JuanGonzalez47/CubeSat_UD34_Electronic_Products_Design/README.md

# CubeSat_UD34_Electronic_Products_Design
Electronic design and architecture of the 1U CubeSat (UD34) nanosatellite for multispectral agricultural monitoring. Electronic Product Design Laboratory - Universidad de Antioquia.
