JuanGonzalez47/CubeSat_UD34_Electronic_Products_Design/Lab04/Informe_tecnico/tablas/costos_detalle.tex

\scriptsize
\setlength{\tabcolsep}{3pt}
\renewcommand{\arraystretch}{1.15}
\begin{longtable}{|>{\raggedright\arraybackslash}p{0.5cm}|>{\raggedright\arraybackslash}p{2.3cm}|>{\raggedright\arraybackslash}p{1.0cm}|>{\raggedright\arraybackslash}p{1.2cm}|>{\raggedright\arraybackslash}p{1.2cm}|>{\raggedright\arraybackslash}p{1.3cm}|>{\raggedright\arraybackslash}p{1.3cm}|>{\raggedright\arraybackslash}p{1.4cm}|>{\raggedright\arraybackslash}p{1.5cm}|>{\raggedright\arraybackslash}p{2.2cm}|}
\hline
\textbf{\#} & \textbf{Designadores} & \textbf{Pzs/tarjeta} & \textbf{USD u. (10)} & \textbf{USD u. (100)} & \textbf{USD u. (1000)} & \textbf{Costo (10)} & \textbf{Costo (100)} & \textbf{Costo (1000)} & \textbf{Estado del precio} \\ \hline
\endfirsthead
\hline
\textbf{\#} & \textbf{Designadores} & \textbf{Pzs/tarjeta} & \textbf{USD u. (10)} & \textbf{USD u. (100)} & \textbf{USD u. (1000)} & \textbf{Costo (10)} & \textbf{Costo (100)} & \textbf{Costo (1000)} & \textbf{Estado del precio} \\ \hline
\endhead
1 & U1 & 1 & 8.0151 & 6.5870 & 6.5870 & 80.15 & 658.70 & 6587.00 & Cotizado \\ \hline
2 & *1 & 1 & 4.6209 & 4.2064 & 3.5938 & 46.21 & 420.64 & 3593.80 & Cotizado (sin stock) \\ \hline
3 & U2 & 1 & 4.8816 & 4.8816 & 4.8816 & 48.82 & 488.16 & 4881.60 & ESTIMADO \\ \hline
4 & U3 & 1 & 0.8819 & 0.6642 & 0.5901 & 8.82 & 66.42 & 590.10 & Cotizado \\ \hline
5 & U4 & 1 & 0.5379 & 0.4006 & 0.3511 & 5.38 & 40.06 & 351.10 & Cotizado \\ \hline
6 & Y1 & 1 & 0.5644 & 0.4321 & 0.4321 & 5.64 & 43.21 & 432.10 & ESTIMADO (variante) \\ \hline
7 & C1, C6 & 2 & 0.0240 & 0.0132 & 0.0080 & 0.48 & 2.64 & 16.00 & Cotizado \\ \hline
8 & R1 & 1 & 0.0340 & 0.0256 & 0.0256 & 0.34 & 2.56 & 25.60 & Cotizado \\ \hline
9 & R6, R7 & 2 & 0.0340 & 0.0256 & 0.0256 & 0.68 & 5.12 & 51.20 & ESTIMADO (proxy) \\ \hline
10 & R2, R3, R4, R5 & 4 & 0.0256 & 0.0256 & 0.0256 & 1.02 & 10.24 & 102.40 & ESTIMADO (proxy) \\ \hline
11 & C2, C5 & 2 & 0.0500 & 0.0200 & 0.0120 & 1.00 & 4.00 & 24.00 & ESTIMADO \\ \hline
12 & C3, C4 & 2 & 0.1000 & 0.0500 & 0.0300 & 2.00 & 10.00 & 60.00 & ESTIMADO \\ \hline
13 & C7 & 1 & 0.1500 & 0.0800 & 0.0500 & 1.50 & 8.00 & 50.00 & ESTIMADO \\ \hline
14 & J1 & 1 & 0.7446 & 0.7423 & 0.6976 & 7.45 & 74.23 & 697.62 & Cotizado (RS, SGD) \\ \hline
15 & J2 (J\_EPS) & 3 & 0.0800 & 0.0500 & 0.0300 & 2.40 & 15.00 & 90.00 & ESTIMADO \\ \hline
16 & J3 (J\_COIL\_X) & 2 & 0.0800 & 0.0500 & 0.0300 & 1.60 & 10.00 & 60.00 & ESTIMADO \\ \hline
17 & J4 (J\_COIL\_Y) & 2 & 0.0800 & 0.0500 & 0.0300 & 1.60 & 10.00 & 60.00 & ESTIMADO \\ \hline
18 & P1 (J\_PAYLOAD) & 5 & 0.0800 & 0.0500 & 0.0300 & 4.00 & 25.00 & 150.00 & ESTIMADO \\ \hline
19 & P2 (J\_CAMERA) & 16 & 0.0500 & 0.0300 & 0.0300 & 8.00 & 48.00 & 480.00 & ESTIMADO \\ \hline
20 & P3 (J\_TELEM) & 4 & 0.0800 & 0.0500 & 0.0300 & 3.20 & 20.00 & 120.00 & ESTIMADO \\ \hline
\end{longtable}
\normalsize
