JuanGonzalez47/CubeSat_UD34_Electronic_Products_Design/Lab04/Informe_tecnico/tablas/costos_resumen.tex

\small
\setlength{\tabcolsep}{3pt}
\renewcommand{\arraystretch}{1.15}
\begin{longtable}{|>{\raggedright\arraybackslash}p{2.8cm}|>{\raggedright\arraybackslash}p{3.6cm}|>{\raggedright\arraybackslash}p{3.6cm}|>{\raggedright\arraybackslash}p{6cm}|}
\hline
\textbf{Tamaño del lote} & \textbf{Costo de componentes del lote (USD)} & \textbf{Costo de componentes por tarjeta (USD)} & \textbf{Observaciones} \\ \hline
\endfirsthead
\hline
\textbf{Tamaño del lote} & \textbf{Costo de componentes del lote (USD)} & \textbf{Costo de componentes por tarjeta (USD)} & \textbf{Observaciones} \\ \hline
\endhead
10 tarjetas & 230.29 & 23.03 & Escalón de 10 piezas en los ICs; poco descuento. \\ \hline
100 tarjetas & 1,961.98 & 19.62 & Se alcanzan escalones de 100+ piezas en los ICs principales. \\ \hline
1000 tarjetas & 18,422.52 & 18.42 & Se aplica el último escalón publicado cuando la cantidad lo supera (conservador). \\ \hline
\end{longtable}
\normalsize
