JuanGonzalez47/CubeSat_UD34_Electronic_Products_Design/Lab04/Informe_tecnico/tablas/restricciones.tex

\tiny
\setlength{\tabcolsep}{3pt}
\renewcommand{\arraystretch}{1.15}
\begin{longtable}{|>{\raggedright\arraybackslash}p{1.1cm}|>{\raggedright\arraybackslash}p{1.8cm}|>{\raggedright\arraybackslash}p{5.6cm}|>{\raggedright\arraybackslash}p{1.6cm}|>{\raggedright\arraybackslash}p{4.0cm}|>{\raggedright\arraybackslash}p{1.8cm}|}
\hline
\textbf{ID} & \textbf{Origen} & \textbf{Restricción y alcance} & \textbf{Tipo} & \textbf{Fuente y fundamento} & \textbf{Estado} \\ \hline
\endfirsthead
\hline
\textbf{ID} & \textbf{Origen} & \textbf{Restricción y alcance} & \textbf{Tipo} & \textbf{Fuente y fundamento} & \textbf{Estado} \\ \hline
\endhead
PCB-01 & ET alimentación / MAIN\_BUS\_POWER & Pista de MAIN\_BUS\_POWER (J\_EPS pin 1) y VM del DRV8833: ancho mínimo según Calculos B28 ($\approx$0,30 mm para 1 A y $\approx$0,53 mm para 1,5 A, $\Delta$T 10 \textdegree{}C, 1 oz externa); usar $\geq$ 1 mm como objetivo de diseño por margen y caída de tensión. Evitar cuellos de botella en vías: mínimo 2 vías 0,3/0,6 mm por transición. & Inferencia + recomendación & IPC-2221 (cálculo en hoja Calculos); corriente supuesta 1 A (informe previo 1-1,5 A). & Pendiente de layout \\ \hline
PCB-02 & Dominio ADCS aislado & Dominios DGND y PGND separados galvánicamente. Distancia mínima (creepage/clearance) entre copper de DGND y de PGND en la zona del ISO7741: $\geq$ 8 mm de pad a pad en el aislador DW (SOIC-16 ancho) y sin cobre ni planos bajo el aislador en la barrera. & Exigida por componente + recomendación & ISO7741DWR: aislamiento 5000 Vrms (DigiKey/TI). Distancia exacta: hoja de datos TI, sección Package/Insulation Specifications (por confirmar valor numérico). & Pendiente de layout \\ \hline
PCB-03 & Dominio ADCS aislado & El plano/retorno de PGND no debe cruzar ni solaparse con DGND. Un único punto de conexión no existe (aislamiento total); los retornos de las bobinas vuelven a PGND por el lado del DRV8833. & Recomendación & Práctica estándar de aislamiento galvánico; cambio documentado en el informe, Sección 2.3. & Pendiente de layout \\ \hline
PCB-04 & DRV8833 / J\_COIL\_X, J\_COIL\_Y & Pad térmico (PowerPAD) de U4 conectado a PGND con matriz de vías térmicas (mín. 5 vías 0,3 mm de taladro) a plano de PGND. Zona de cobre ampliada alrededor del pad. & Recomendación del fabricante & Hoja de datos DRV8833, sección Layout (PowerPAD) - confirmar número de vías recomendado. & Pendiente de layout \\ \hline
PCB-05 & STM32H753 / alimentación & Un condensador de desacoplamiento de 100 nF por cada par VDD/VSS, a $\leq$ 3 mm del pin, con vía directa al plano. El esquemático actual NO incluye estos condensadores (ver Desviaciones D-08); deben añadirse o compensarse con condensadores en la zona de layout. & Exigida por hoja de datos & AN4938 / datasheet STM32H753 (sección Power supply scheme). Cantidad exacta por confirmar. & Desviación abierta \\ \hline
PCB-06 & STM32H753 / VCAP & Condensadores VCAP (C3, C4 de 2,2 uF) lo más cerca posible de los pines VCAP (81, 125), ESR < 100 mohm (cerámico X7R/X5R). & Exigida por hoja de datos & Datasheet STM32H753, sección Power supply scheme (VCAP). Confirmar valor y ESR. & Pendiente de layout \\ \hline
PCB-07 & Reloj HSE & Cristal Y1 y condensadores C2, C5 juntos, a $\leq$ 5 mm de PH0/PH1; sin pistas de otras señales ni vías bajo el cristal; guarda de GND (DGND) alrededor. & Recomendación del fabricante & AN2867 (Oscillator design guide for STM8/STM32) - confirmar aplicabilidad al H7. & Pendiente de layout \\ \hline
PCB-08 & Reloj HSE & Capacitancia de carga CL = 18 pF (a verificar): requiere Cext $\approx$ 30 pF por lado con Cstray = 3 pF; instalado 16 pF. Desviación abierta. & Exigida por hoja de datos & Hoja de datos ABM3B-25.000MHZ-B4U-T (por confirmar) + Calculos B3-B9. & Desviación abierta \\ \hline
PCB-09 & IF-04 PAYLOAD\_SPI & SPI hacia el payload: resistencias serie de 33 ohm (R2-R5) ubicadas cerca del origen (STM32). Longitud de pista < 100 mm si es posible; sin cruces de planos. & Recomendación & Práctica de integridad de señal; impedancia no controlada en esta etapa. & Pendiente de layout \\ \hline
PCB-10 & IF-05 TELEMETRY\_I2C & Pull-ups de 4,7 kohm (R6, R7) a 3V3\_DIGITAL dentro del intervalo [967 ohm; 7,08 kohm]. & Cálculo & Hoja Calculos B16-B19 (especificación I2C). & Cumple \\ \hline
PCB-11 & IF-01 CAMERA\_DCMI & Bus DCMI (D0-D7, PCLK, HSYNC, VSYNC): grupo de longitud con diferencia máxima entre D0-D7 y PCLK a definir en la guía de enrutamiento (objetivo preliminar $\leq$ 5 mm); referencia continua de plano. & Inferencia (objetivo) & Requisito ET-01 $\geq$ 40 MB/s (informe). Valor numérico por derivar de la hoja de datos de la cámara (no disponible en este paquete). & Pendiente (valor por definir) \\ \hline
PCB-12 & FMC\_BUS (SDRAM) & Bus FMC SDRAM: línea de reloj FMC\_SDCLK emparejada en longitud con el grupo de datos/control (objetivo $\leq$ 10 mm de diferencia); cobertura por plano de referencia; la SDRAM junto al STM32. & Inferencia (objetivo) & Práctica común para SDRAM síncrona (timing del MT48LC4M16A2P-6A, hoja de datos: sección AC Timing). Valores numéricos por confirmar. & Pendiente (valor por definir) \\ \hline
PCB-13 & SDIO\_BUS (eMMC) & Bus SDIO: CLK separado de D0-D7 y CMD; diferencia de longitud entre líneas $\leq$ 5 mm (objetivo); eMMC en BGA FBGA-153: abanico con vías de 0,15-0,2 mm (HDI o POFV según proveedor). & Inferencia + límite de fabricación & Datasheet Kingston EMMC04G-M627-A01 (por confirmar) y guía BGA de JLCPCB (\url{https://jlcpcb.com/help/article/243-BGA-Design-Guidelines---PCB-Layout-Recommendations-for-BGA-packages}). & Pendiente de layout \\ \hline
PCB-14 & SWD (J1) & SWDIO y SWCLK cortos (< 50 mm) hacia el conector J1; NRST disponible en test point. & Recomendación & Práctica; el informe prevé puntos de prueba NRST, VCAP, 3.3V\_Iso y PWM. & Desviación abierta \\ \hline
PCB-15 & Térmico & Disipación del DRV8833 y de las pistas de bobinas: cobre de superficie ampliado y, si se justifica, capa interna de potencia; $\Delta$T admisible 10 \textdegree{}C como objetivo. & Recomendación & Hoja de datos DRV8833; IPC-2221. & Pendiente \\ \hline
PCB-16 & Conectores & J1 (53259-0429) y cabeceras de cables en el borde de la tarjeta; huella de THT con agujeros de taladro según datasheet Molex; pitch 3,5 mm (J1). & Exigida por huella & Datasheet Molex 53259-0429 (patrón recomendado). & Pendiente de verificación \\ \hline
FAB-01 & Proveedor & Proveedor elegido: JLCPCB (fabricación de PCB rígida estándar). Capacidades consultadas el 27/10/2026 en \url{https://jlcpcb.com/capabilities/pcb-capabilities} y \url{https://api.jlcpcb.com/capabilities/Capabilities.} Los valores pueden cambiar; reconsultar antes del pedido. & Fuente externa & JLCPCB, páginas de capacidades (fecha de consulta 27/10/2026). & Documentado \\ \hline
FAB-02 & Apilamiento & Número de capas preliminar: 4 capas (señal / GND / alimentación / señal), FR-4, 1,6 mm, cobre exterior 1 oz (0,035 mm). Justificación: BGA FBGA-153, 176 pines LQFP, bus FMC de 38 señales y dominios aislados. Cálculo de impedancias y apilamiento definitivos quedan para la guía de enrutamiento. & Inferencia & JLCPCB: soporta 1-32 capas, impedancia controlada de 4 capas en adelante, con apilamientos por defecto. & Pendiente (valor preliminar) \\ \hline
FAB-03 & Pistas y separación & Ancho y separación mínimos en capa exterior a usar en diseño: $\geq$ 0,127 mm (5 mil) / 0,127 mm (5 mil) para 1-2 capas; objetivo de diseño $\geq$ 0,15 mm / 0,15 mm para tener margen. En multicapa JLCPCB indica 3,5 mil como límite; no se usa por margen. & Límite de fabricante & JLCPCB capabilities (resumen verificado vía secundaria: Trace width/spacing 5 mil 1-2L; 3,5 mil multicapa). Reconsultar el valor exacto de 4 capas en la página oficial. & Pendiente de layout \\ \hline
FAB-04 & Vías y taladros & Vía estándar: taladro 0,3 mm / diámetro 0,5 mm (2 capas) o taladro 0,2 mm / diámetro 0,45 mm (multicapa); vías de abanico de BGA con taladro 0,15 mm / diámetro 0,25 mm (según la guía BGA y 'Via-in-pad' con relleno, POFV gratuito en 6-20 capas). Taladro mínimo 0,2 mm; máximo 6,3 mm. & Límite de fabricante & JLCPCB capabilities (\url{https://api.jlcpcb.com/capabilities/Capabilities}) y guía BGA (\url{https://jlcpcb.com/help/article/243-BGA-Design-Guidelines---PCB-Layout-Recommendations-for-BGA-packages}). & Pendiente de layout \\ \hline
FAB-05 & Anillo anular / máscara & Anillo anular mínimo de pad $\geq$ 0,15 mm sobre el taladro (valor registrado por fuente secundaria). Puente de máscara de soldadura mínimo según proveedor; verificar para el paso de 0,5 mm del LQFP-176 y del FBGA-153. & Límite de fabricante & JLCPCB (valores a confirmar en la página oficial); la separación mínima entre pines de IC es 0,4 mm (0,35 mm extremo). & Pendiente (confirmar) \\ \hline
FAB-06 & Borde de tarjeta & Distancia de pista a borde $\geq$ 0,2 mm (fresado) como límite del fabricante; objetivo de diseño $\geq$ 0,3 mm. Tamaño de lote en prototipo: tarjeta individual 70x70 mm mínimo / 400x500 mm máximo en el servicio estándar. & Límite de fabricante & JLCPCB capabilities (Trace to Outline 0,2 mm; Single PCB Size). & Pendiente \\ \hline
FAB-07 & Tamaño de la placa & Tamaño de la PCB debe respetar el formato 1U del CubeSat (\textasciitilde{} 90 x 96 mm de la placa PC/104). Si es menor de 70 x 70 mm, verificar los mínimos del servicio estándar de JLCPCB. & Inferencia & Estándar CubeSat 1U / PC/104 (por confirmar en la arquitectura de la práctica 3). & Pendiente \\ \hline
FAB-08 & Servicios especiales & Posible necesidad de servicio especial: vía rellena (POFV/via-in-pad) y/o HDI para el FBGA-153 a paso 0,5 mm; impedancia controlada si se exige. Identificado para consultar a JLCPCB. & Inferencia & Guía BGA de JLCPCB. & Pendiente \\ \hline
\end{longtable}
\normalsize
