JuanGonzalez47/CubeSat_UD34_Electronic_Products_Design/Lab03/Diagrama/Diagrama_con_pcb.png

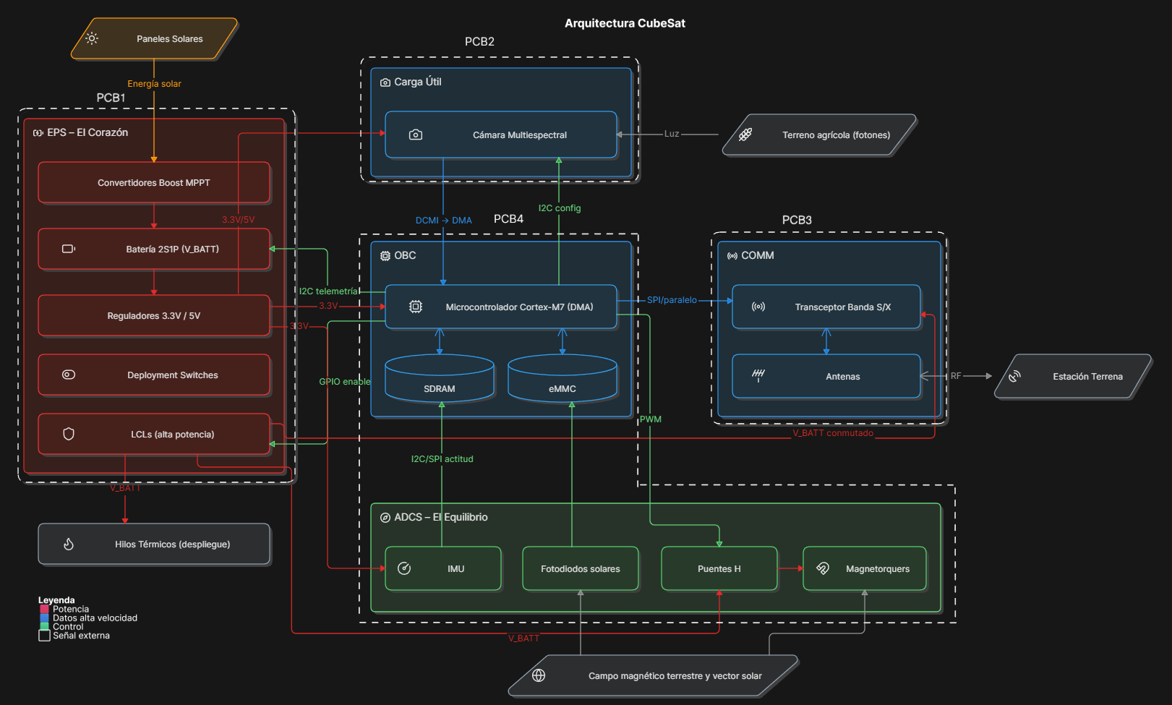
Lab03/Diagrama/Diagrama_con_pcb.png
