JuanGonzalez47/CubeSat_UD34_Electronic_Products_Design/Lab04/Informe_tecnico/tablas/bom.tex

\scriptsize
\setlength{\tabcolsep}{3pt}
\renewcommand{\arraystretch}{1.15}
\begin{longtable}{|>{\raggedright\arraybackslash}p{0.5cm}|>{\raggedright\arraybackslash}p{2.2cm}|>{\raggedright\arraybackslash}p{3.8cm}|>{\raggedright\arraybackslash}p{0.8cm}|>{\raggedright\arraybackslash}p{2.2cm}|>{\raggedright\arraybackslash}p{3.2cm}|>{\raggedright\arraybackslash}p{2.4cm}|}
\hline
\textbf{\#} & \textbf{Designadores} & \textbf{Descripción} & \textbf{Cant.} & \textbf{Fabricante} & \textbf{Referencia (MPN)} & \textbf{Encapsulado} \\ \hline
\endfirsthead
\hline
\textbf{\#} & \textbf{Designadores} & \textbf{Descripción} & \textbf{Cant.} & \textbf{Fabricante} & \textbf{Referencia (MPN)} & \textbf{Encapsulado} \\ \hline
\endhead
1 & U1 & Microcontrolador ARM Cortex-M7 480 MHz, 2 MB Flash & 1 & STMicroelectronics & STM32H753IIT6 & LQFP-176 (24x24) \\ \hline
2 & *1 & eMMC 4 GB & 1 & Kingston & EMMC04G-M627-A01 & FBGA-153 \\ \hline
3 & U2 & SDRAM 64 Mbit (4M x 16), 3,3 V & 1 & Micron & MT48LC4M16A2P-6A & TSOP-II 54 \\ \hline
4 & U3 & Aislador digital 4 canales (3 + 1), 5 kVrms & 1 & Texas Instruments & ISO7741DWR & SOIC-16 DW \\ \hline
5 & U4 & Puente H doble 2,7-10,8 V & 1 & Texas Instruments & DRV8833PWPR & HTSSOP-16 (PowerPAD) \\ \hline
6 & Y1 & Cristal 25 MHz (HSE) & 1 & Abracon & ABM3B-25.000MHZ-B4U-T & SMD 5,0 x 3,2 mm, 4 pines \\ \hline
7 & C1, C6 & Condensador cerámico 0,1 uF X7R 16 V & 2 & Murata & GRM155R71C104KA88D & 0402 \\ \hline
8 & R1 & Resistencia 10 kOhm 1 \% 0603 & 1 & Panasonic & ERJ3EKF1002V & 0603 \\ \hline
9 & R6, R7 & Resistencia 4,7 kOhm 0603 & 2 & Panasonic (a definir) & Serie ERJ3EKF (valor 4,7 kOhm, MPN por confirmar) & 0603 \\ \hline
10 & R2, R3, R4, R5 & Resistencia serie 33 ohm 0603 & 4 & Panasonic (a definir) & Serie ERJ3EKF (valor 33 ohm, MPN por confirmar) & 0603 \\ \hline
11 & C2, C5 & Condensador 16 pF C0G (carga del cristal) & 2 & A definir & Por confirmar & 0402 (a verificar) \\ \hline
12 & C3, C4 & Condensador 2,2 uF (VCAP del STM32) & 2 & A definir & Por confirmar & 0603 (a verificar) \\ \hline
13 & C7 & Condensador 10 uF (filtrado J\_EPS) & 1 & A definir & Por confirmar & 0805 (a verificar) \\ \hline
14 & J1 & Cabecera 4 pines 3,5 mm SWD & 1 & Molex & 53259-0429 & THT acodada 3,5 mm \\ \hline
15 & J2 (J\_EPS) & Cabecera 3 pines (potencia EPS) & 1 & Genérico & Sin referencia comercial & Cabecera 3 pines \\ \hline
16 & J3 (J\_COIL\_X) & Cabecera 2 pines (bobina X) & 1 & Genérico & Sin referencia comercial & Cabecera 2 pines \\ \hline
17 & J4 (J\_COIL\_Y) & Cabecera 2 pines (bobina Y) & 1 & Genérico & Sin referencia comercial & Cabecera 2 pines \\ \hline
18 & P1 (J\_PAYLOAD) & Cabecera 5 pines (SPI + DGND) & 1 & Genérico & Sin referencia comercial & Cabecera 5 pines \\ \hline
19 & P2 (J\_CAMERA) & Cabecera 16 pines (DCMI + I2C + 3V3 + DGND) & 1 & Genérico & Sin referencia comercial & Cabecera 16 pines \\ \hline
20 & P3 (J\_TELEM) & Cabecera 4 pines (I2C + 3V3 + DGND) & 1 & Genérico & Sin referencia comercial & Cabecera 4 pines \\ \hline
\end{longtable}
\normalsize
