JuanGonzalez47/CubeSat_UD34_Electronic_Products_Design/Lab04/Calculos_BOM/UD34_PCB2_Calculos_BOM_Costos.xlsx

Sheet: Leeme
PCB 2 (OBC + ADCS) - CubeSat UD34 - Práctica 4
Hoja de cálculo de soporte: supuestos, BOM, costos, cálculos, matriz de restricciones, registro ERC y desviaciones.
Integrantes: Juan Pablo González Blandón, Santiago Castaño Loaiza. Altium Designer 26.9.1. Fecha de consulta de precios y proveedor: 27/10/2026.
Hojas
Supuestos: tipo de cambio, tamaños de lote, constantes (celdas amarillas = editables).
Precios: escalones de precio por componente (fuente, moneda, fecha). Fondo naranja = precio ESTIMADO sin cotización.
BOM: lista de materiales del esquemático entregado (as-built).
Costos: costo por lote 10/100/1000 con fórmulas, y costo por tarjeta + gráfica.
Calculos: cristal HSE, pull-ups I2C, ancho de pista (IPC-2221), consumo.
Restricciones: matriz de restricciones de PCB y de fabricación (ID, restricción, fuente, verificación, estado).
ERC: registro de la validación automática y manual, con excepciones aceptadas.
Desviaciones: diferencias entre la especificación/informe previo y el esquemático as-built.
Convenciones
Amarillo = dato de entrada editable. Naranja = valor estimado/pendiente de cotización. Verde = encabezado.
Los precios con escalones usan el escalón de cantidad correspondiente a la cantidad de piezas del lote (cantidad por tarjeta x tarjetas), no al número de tarjetas.
Si la cantidad supera el último escalón publicado, se aplica el último precio publicado (conservador). Los escalones no usados se rellenan con cantidades ficticias >= 1.000.000 y el último precio.
No incluye fabricación de la PCB, ensamblaje, transporte ni impuestos.

Sheet: Supuestos
Parámetro | Valor | Unidad | Fuente / nota
Tarjetas en lote 1 | 10 | uds | Guía Práctica 4, paso 11
Tarjetas en lote 2 | 100 | uds | Guía Práctica 4, paso 11
Tarjetas en lote 3 | 1000 | uds | Guía Práctica 4, paso 11
Tipo de cambio SGD -> USD | 0.77 | USD/SGD | SUPUESTO del equipo (aprox.). Actualizar con la tasa del día de compra.
Tipo de cambio EUR -> USD | 1.08 | USD/EUR | SUPUESTO del equipo (aprox.). Actualizar con la tasa del día de compra.
Fecha de consulta de precios | 27/10/2026 |  | Precios de referencia; cambian a diario

Sheet: Precios
Clave | Componente (MPN) | Moneda origen | Factor a USD | Q1 | Q2 | Q3 | Q4 | Q5 | Q6 | Q7 | P1 | P2 | P3 | P4 | P5 | P6 | P7 | Estado | Fuente (fecha 27/10/2026)
STM32 | STM32H753IIT6 | USD | 1 | 1 | 10 | 30 | 100 | 1000000 | 2000000 | 3000000 | 9.2873 | 8.0151 | 7.2387 | 6.5870 | 6.5870 | 6.5870 | 6.5870 | Cotizado | LCSC C146558 (https://www.lcsc.com/product-image/C146558.html). Referencia; DigiKey/TME muestran 0 o poco stock.
EMMC | EMMC04G-M627-A01 (Kingston) | USD | 1 | 1 | 10 | 30 | 152 | 456 | 1064 | 1976 | 5.3178 | 4.6209 | 4.2064 | 3.7873 | 3.5938 | 3.5063 | 3.4680 | Cotizado (sin stock) | LCSC C577446 (https://www.lcsc.com/product-image/C577446.html). Aparece sin stock: disponibilidad PENDIENTE.
SDRAM | MT48LC4M16A2P-6A (Micron) | EUR | 1.08 | 1 | 1000000 | 2000000 | 3000000 | 4000000 | 5000000 | 6000000 | 4.5200 | 4.5200 | 4.5200 | 4.5200 | 4.5200 | 4.5200 | 4.5200 | ESTIMADO | DigiKey ES MT48LC4M16A2P-6A IT:J TR, 4,52 EUR sin IVA, un solo escalón visible (https://www.digikey.com/en/products/detail/micron-technology-inc/MT48LC4M16A2P-6A-IT-J-TR/4315481). Estado 'Last Time Buy' (fecha 30/06/2026 ya vencida): disponibilidad PENDIENTE; se aplica el mismo precio a los 3 lotes.
ISO | ISO7741DWR (TI) | USD | 1 | 1 | 10 | 30 | 100 | 500 | 1000 | 1000000 | 1.0689 | 0.8819 | 0.7803 | 0.6642 | 0.6126 | 0.5901 | 0.5901 | Cotizado | LCSC C571196 (https://www.lcsc.com/product-image/C571196.html). Otros distribuidores muestran precios mayores (p.ej. 2,57 EUR en DigiKey DE sin stock).
DRV | DRV8833PWPR (TI) | USD | 1 | 1 | 10 | 30 | 100 | 500 | 1000 | 1000000 | 0.6751 | 0.5379 | 0.4692 | 0.4006 | 0.3735 | 0.3511 | 0.3511 | Cotizado | LCSC C50506 (https://www.lcsc.com/product-image/C50506.html). DigiKey/Mouser muestran 1,68-2,34 USD.
XTAL | ABM3B-25.000MHZ-B4U-T (Abracon) | USD | 1 | 1 | 10 | 30 | 100 | 1000000 | 2000000 | 3000000 | 0.6966 | 0.5644 | 0.4983 | 0.4321 | 0.4321 | 0.4321 | 0.4321 | ESTIMADO (variante) | Sin cotización de la referencia exacta. Se usa como proxy la variante ABM3B-25.000MHZ-B2-T en LCSC C596875 (https://www.lcsc.com/product-image/C596875.html).
C100N | GRM155R71C104KA88D (Murata) 0,1 uF 0402 | USD | 1 | 1 | 10 | 50 | 100 | 500 | 1000 | 5000 | 0.1000 | 0.0240 | 0.0156 | 0.0132 | 0.0093 | 0.0080 | 0.0060 | Cotizado | DigiKey 490-3261-1-ND vía OEMsTrade (https://www.oemstrade.com/search/grm155r71c104ka88d%200402-104k%20pb-free).
R10K | ERJ3EKF1002V (Panasonic) 10 kOhm 0603 | USD | 1 | 1 | 10 | 25 | 1000000 | 2000000 | 3000000 | 4000000 | 0.1000 | 0.0340 | 0.0256 | 0.0256 | 0.0256 | 0.0256 | 0.0256 | Cotizado | DigiKey P10.0KHCT-ND (https://www.digikey.com/en/products/detail/panasonic-electronic-components/ERJ-3EKF1002V/196066). Solo se ven 3 escalones; se mantiene el último.
R_GEN | Resistencias 33 ohm / 4,7 kohm 0603 1 % | USD | 1 | 1 | 10 | 25 | 1000000 | 2000000 | 3000000 | 4000000 | 0.1000 | 0.0340 | 0.0256 | 0.0256 | 0.0256 | 0.0256 | 0.0256 | ESTIMADO (proxy) | Sin cotización de la referencia exacta; se usa el precio de la serie ERJ3EKF (ERJ3EKF1002V).
C_PF | Condensador 16 pF C0G 0402 | USD | 1 | 1 | 100 | 1000 | 1000000 | 2000000 | 3000000 | 4000000 | 0.0500 | 0.0200 | 0.0120 | 0.0120 | 0.0120 | 0.0120 | 0.0120 | ESTIMADO | Sin cotización. Estimación del equipo; reemplazar al definir la referencia exacta.
C_2U2 | Condensador 2,2 uF (VCAP) | USD | 1 | 1 | 100 | 1000 | 1000000 | 2000000 | 3000000 | 4000000 | 0.1000 | 0.0500 | 0.0300 | 0.0300 | 0.0300 | 0.0300 | 0.0300 | ESTIMADO | Sin cotización. Estimación del equipo; reemplazar al definir la referencia exacta.
C_10U | Condensador 10 uF | USD | 1 | 1 | 100 | 1000 | 1000000 | 2000000 | 3000000 | 4000000 | 0.1500 | 0.0800 | 0.0500 | 0.0500 | 0.0500 | 0.0500 | 0.0500 | ESTIMADO | Sin cotización. Estimación del equipo; reemplazar al definir la referencia exacta.
J_SWD | Molex 53259-0429 (4 pines, 3,5 mm) | SGD | 0.77 | 1 | 10 | 50 | 250 | 750 | 2250 | 1000000 | 0.9670 | 0.9670 | 0.9640 | 0.9500 | 0.9060 | 0.7820 | 0.7820 | Cotizado (RS, SGD) | RS 602-1299, paquete de 10 (https://sg.rs-online.com/web/p/pcb-headers/6021299). Escalones 10-40, 50-240, 250-740, 750-2240, 2250+.
HDR_PIN | Cabecera genérica, precio por pin | USD | 1 | 1 | 100 | 1000 | 1000000 | 2000000 | 3000000 | 4000000 | 0.0800 | 0.0500 | 0.0300 | 0.0300 | 0.0300 | 0.0300 | 0.0300 | ESTIMADO | Los conectores J_EPS, J_COIL_X/Y, J_PAYLOAD, J_CAMERA y J_TELEM son símbolos genéricos sin referencia comercial; se estima por pin.

Sheet: BOM
Línea | Designadores | Descripción | Cant./tarjeta | Fabricante | Referencia exacta (MPN) | Encapsulado / huella | Hoja esquemática | Estado de montaje | Clave de precio | Pines (solo cabeceras) | Observaciones
1 | U1 | Microcontrolador ARM Cortex-M7 480 MHz, 2 MB Flash | 1 | STMicroelectronics | STM32H753IIT6 | LQFP-176 (24x24) | U_OBC_Core | Montado | STM32 |  | Símbolo en 3 partes (U1A/U1B/U1C).
2 | *1 | eMMC 4 GB | 1 | Kingston | EMMC04G-M627-A01 | FBGA-153 | U_Mass_Storage | Montado | EMMC |  | Designador *1 tras anotar. VCC y VCCQ a 3V3_DIGITAL (el informe previo decía VCCQ 1,8 V).
3 | U2 | SDRAM 64 Mbit (4M x 16), 3,3 V | 1 | Micron | MT48LC4M16A2P-6A | TSOP-II 54 | U_Mass_Storage | Montado | SDRAM |  | Estado Last Time Buy en DigiKey (30/06/2026).
4 | U3 | Aislador digital 4 canales (3 + 1), 5 kVrms | 1 | Texas Instruments | ISO7741DWR | SOIC-16 DW | U_ADCS_Isolated | Montado | ISO |  | Solo 3 canales en el mismo sentido: PWM_B2 queda sin conexión.
5 | U4 | Puente H doble 2,7-10,8 V | 1 | Texas Instruments | DRV8833PWPR | HTSSOP-16 (PowerPAD) | U_ADCS_Isolated | Montado | DRV
6 | Y1 | Cristal 25 MHz (HSE) | 1 | Abracon | ABM3B-25.000MHZ-B4U-T | SMD 5,0 x 3,2 mm, 4 pines | U_OBC_Core | Montado | XTAL |  | Capacitancia de carga a verificar con la hoja de datos (ver Calculos).
7 | C1, C6 | Condensador cerámico 0,1 uF X7R 16 V | 2 | Murata | GRM155R71C104KA88D | 0402 | U_OBC_Core (C1), U_Interfaces_Connectors (C6) | Montado | C100N |  | C1 en SYS_RESET; C6 en J_EPS.
8 | R1 | Resistencia 10 kOhm 1 % 0603 | 1 | Panasonic | ERJ3EKF1002V | 0603 | U_OBC_Core | Montado | R10K |  | Pull-down de BOOT0.
9 | R6, R7 | Resistencia 4,7 kOhm 0603 | 2 | Panasonic (a definir) | Serie ERJ3EKF (valor 4,7 kOhm, MPN por confirmar) | 0603 | U_OBC_Core | Montado | R_GEN |  | Pull-ups I2C.
10 | R2, R3, R4, R5 | Resistencia serie 33 ohm 0603 | 4 | Panasonic (a definir) | Serie ERJ3EKF (valor 33 ohm, MPN por confirmar) | 0603 | U_OBC_Core | Montado | R_GEN |  | Terminación serie SPI (NSS, SCK, MISO, MOSI).
11 | C2, C5 | Condensador 16 pF C0G (carga del cristal) | 2 | A definir | Por confirmar | 0402 (a verificar) | U_OBC_Core | Montado | C_PF |  | Valor a revisar frente a la capacitancia de carga del cristal.
12 | C3, C4 | Condensador 2,2 uF (VCAP del STM32) | 2 | A definir | Por confirmar | 0603 (a verificar) | U_OBC_Core | Montado | C_2U2 |  | Condensadores VCAP1/VCAP2.
13 | C7 | Condensador 10 uF (filtrado J_EPS) | 1 | A definir | Por confirmar | 0805 (a verificar) | U_Interfaces_Connectors | Montado | C_10U
14 | J1 | Cabecera 4 pines 3,5 mm SWD | 1 | Molex | 53259-0429 | THT acodada 3,5 mm | U_OBC_Core | Montado | J_SWD |  | Conector de depuración SWD (3V3, SWCLK, SWDIO, DGND).
15 | J2 (J_EPS) | Cabecera 3 pines (potencia EPS) | 1 | Genérico | Sin referencia comercial | Cabecera 3 pines | U_Interfaces_Connectors | Montado | HDR_PIN | 3 | Solo MAIN_BUS_POWER, 3V3_DIGITAL y DGND.
16 | J3 (J_COIL_X) | Cabecera 2 pines (bobina X) | 1 | Genérico | Sin referencia comercial | Cabecera 2 pines | U_Interfaces_Connectors | Montado | HDR_PIN | 2
17 | J4 (J_COIL_Y) | Cabecera 2 pines (bobina Y) | 1 | Genérico | Sin referencia comercial | Cabecera 2 pines | U_Interfaces_Connectors | Montado | HDR_PIN | 2
18 | P1 (J_PAYLOAD) | Cabecera 5 pines (SPI + DGND) | 1 | Genérico | Sin referencia comercial | Cabecera 5 pines | U_Interfaces_Connectors | Montado | HDR_PIN | 5
19 | P2 (J_CAMERA) | Cabecera 16 pines (DCMI + I2C + 3V3 + DGND) | 1 | Genérico | Sin referencia comercial | Cabecera 16 pines | U_Interfaces_Connectors | Montado | HDR_PIN | 16
20 | P3 (J_TELEM) | Cabecera 4 pines (I2C + 3V3 + DGND) | 1 | Genérico | Sin referencia comercial | Cabecera 4 pines | U_Interfaces_Connectors | Montado | HDR_PIN | 4
Componentes opcionales o no montados: ninguno. Configuración usada para el costo: todos los componentes de esta lista montados.
Total de componentes por tarjeta (unidades): |  |  |  |  | 27

Sheet: Costos
Línea BOM | Designadores | Clave | Cant./tarjeta (piezas) | Piezas lote 1 | Piezas lote 2 | Piezas lote 3 | Precio unit. USD lote 1 | Precio unit. USD lote 2 | Precio unit. USD lote 3 | Costo USD lote 1 | Costo USD lote 2 | Costo USD lote 3 | Estado del precio
1 | U1 | STM32 | 1 | 10 | 100 | 1000 | 8.0151 | 6.5870 | 6.5870 | 80.15 | 658.70 | 6587.00 | Cotizado
2 | *1 | EMMC | 1 | 10 | 100 | 1000 | 4.6209 | 4.2064 | 3.5938 | 46.21 | 420.64 | 3593.80 | Cotizado (sin stock)
3 | U2 | SDRAM | 1 | 10 | 100 | 1000 | 4.8816 | 4.8816 | 4.8816 | 48.82 | 488.16 | 4881.60 | ESTIMADO
4 | U3 | ISO | 1 | 10 | 100 | 1000 | 0.8819 | 0.6642 | 0.5901 | 8.82 | 66.42 | 590.10 | Cotizado
5 | U4 | DRV | 1 | 10 | 100 | 1000 | 0.5379 | 0.4006 | 0.3511 | 5.38 | 40.06 | 351.10 | Cotizado
6 | Y1 | XTAL | 1 | 10 | 100 | 1000 | 0.5644 | 0.4321 | 0.4321 | 5.64 | 43.21 | 432.10 | ESTIMADO (variante)
7 | C1, C6 | C100N | 2 | 20 | 200 | 2000 | 0.0240 | 0.0132 | 0.0080 | 0.48 | 2.64 | 16.00 | Cotizado
8 | R1 | R10K | 1 | 10 | 100 | 1000 | 0.0340 | 0.0256 | 0.0256 | 0.34 | 2.56 | 25.60 | Cotizado
9 | R6, R7 | R_GEN | 2 | 20 | 200 | 2000 | 0.0340 | 0.0256 | 0.0256 | 0.68 | 5.12 | 51.20 | ESTIMADO (proxy)
10 | R2, R3, R4, R5 | R_GEN | 4 | 40 | 400 | 4000 | 0.0256 | 0.0256 | 0.0256 | 1.02 | 10.24 | 102.40 | ESTIMADO (proxy)
11 | C2, C5 | C_PF | 2 | 20 | 200 | 2000 | 0.0500 | 0.0200 | 0.0120 | 1.00 | 4.00 | 24.00 | ESTIMADO
12 | C3, C4 | C_2U2 | 2 | 20 | 200 | 2000 | 0.1000 | 0.0500 | 0.0300 | 2.00 | 10.00 | 60.00 | ESTIMADO
13 | C7 | C_10U | 1 | 10 | 100 | 1000 | 0.1500 | 0.0800 | 0.0500 | 1.50 | 8.00 | 50.00 | ESTIMADO
14 | J1 | J_SWD | 1 | 10 | 100 | 1000 | 0.7446 | 0.7423 | 0.6976 | 7.45 | 74.23 | 697.62 | Cotizado (RS, SGD)
15 | J2 (J_EPS) | HDR_PIN | 3 | 30 | 300 | 3000 | 0.0800 | 0.0500 | 0.0300 | 2.40 | 15.00 | 90.00 | ESTIMADO
16 | J3 (J_COIL_X) | HDR_PIN | 2 | 20 | 200 | 2000 | 0.0800 | 0.0500 | 0.0300 | 1.60 | 10.00 | 60.00 | ESTIMADO
17 | J4 (J_COIL_Y) | HDR_PIN | 2 | 20 | 200 | 2000 | 0.0800 | 0.0500 | 0.0300 | 1.60 | 10.00 | 60.00 | ESTIMADO
18 | P1 (J_PAYLOAD) | HDR_PIN | 5 | 50 | 500 | 5000 | 0.0800 | 0.0500 | 0.0300 | 4.00 | 25.00 | 150.00 | ESTIMADO
19 | P2 (J_CAMERA) | HDR_PIN | 16 | 160 | 1600 | 16000 | 0.0500 | 0.0300 | 0.0300 | 8.00 | 48.00 | 480.00 | ESTIMADO
20 | P3 (J_TELEM) | HDR_PIN | 4 | 40 | 400 | 4000 | 0.0800 | 0.0500 | 0.0300 | 3.20 | 20.00 | 120.00 | ESTIMADO
 | TOTAL lote (USD) |  |  |  |  |  |  |  |  | 230.29 | 1961.98 | 18422.52
 | Costo por tarjeta (USD) |  |  |  |  |  |  |  |  | 23.03 | 19.62 | 18.42
 | Parte del costo por tarjeta con precio ESTIMADO (%) |  |  |  |  |  |  |  |  | 35.4% | 35.5% | 35.6%
 | Tamaño del lote | Costo de componentes del lote (USD) | Costo por tarjeta (USD) | Observaciones
 | 10 | 230.29 | 23.03 | Escalón de 10 piezas en los ICs; poco descuento.
 | 100 | 1961.98 | 19.62 | Se alcanzan escalones de 100+ piezas en los ICs principales.
 | 1000 | 18422.52 | 18.42 | Se aplica el último escalón publicado cuando la cantidad lo supera (conservador).
 | Sobrantes: se compra exactamente la cantidad de piezas requeridas (múltiplo de empaque = 1, venta por unidad/cinta cortada). Si el proveedor exige bandeja o carrete completo (p.ej. eMMC bandeja de 152), el costo y los sobrantes cambian.

Sheet: Calculos
Cálculo / parámetro | Valor | Unidad | Fuente o nota
1. Cristal HSE (red de carga)
CL del cristal ABM3B-25.000MHZ-B4U-T | 18 | pF | Valor reportado por un distribuidor (ibselectronics.cn). VERIFICAR con la hoja de datos de Abracon. El informe previo usaba 8 pF, que no corresponde a esta referencia.
C parásita estimada (pista + pines) | 3 | pF | SUPUESTO típico 2-5 pF
C externa requerida por condensador = 2(CL - Cstray) | 30 | pF | Fórmula CL = C1*C2/(C1+C2) + Cstray con C1 = C2
C externa instalada (C2, C5 en el esquemático) | 16.0 | pF | Esquemático as-built
CL efectiva con C instalada = Cext/2 + Cstray | 11.0 | pF | Con 16 pF resulta menor que el CL del cristal
Desviación de CL (efectiva - requerida) | -7.0 | pF | Negativa: la frecuencia de oscilación queda ligeramente por encima de la nominal. DESVIACIÓN DOCUMENTADA (ver hoja Desviaciones); corregir a ~30 pF o cambiar el cristal en la siguiente revisión.
2. Pull-ups I2C
Vcc | 3.3 | V | 3V3_DIGITAL
VOL | 0.4 | V | Especificación I2C
IOL | 0.003 | A | Especificación I2C modo estándar/rápido
tr máximo | 3e-07 | s | Modo rápido (300 ns)
Cb (capacitancia del bus) | 5e-11 | F | SUPUESTO del equipo
Rp mínimo = (Vcc - VOL)/IOL | 966.6666667 | ohm
Rp máximo = tr/(0,8473 Cb) | 7081.317125 | ohm
Rp adoptado (R6, R7) | 4700 | ohm | Dentro del intervalo [Rp mín, Rp máx]
Verificación | CUMPLE
3. Ancho de pista por corriente (IPC-2221, capa externa)
Corriente de diseño por bobina | 1 | A | SUPUESTO. El informe previo estimaba 1,0-1,5 A por eje. La corriente real depende de la resistencia de la bobina y de VM.
Aumento de temperatura admisible | 10 | °C | SUPUESTO
Espesor de cobre | 1 | oz | SUPUESTO preliminar (1 oz = 1,378 mil); falta definir con el apilamiento
k (capa externa) | 0.048 |  | IPC-2221
Área de sección = (I/(k·ΔT^0,44))^(1/0,725) | 16.3 | mil² | IPC-2221
Ancho mínimo | 11.8 | mil
Ancho mínimo en mm | 0.30 | mm | Registrar con margen (p.ej. x1,5-2); la caída de tensión y la temperatura final pueden exigir mayor ancho
Ancho con corriente 1,5 A (para comparar) | 0.53 | mm
4. Consumo de la tarjeta (valores heredados del informe)
Corriente digital nominal a 3,3 V | 0.1 | A | Valor del informe previo (estimado; sin verificar con hojas de datos)
Corriente digital pico a 3,3 V | 0.25 | A | Valor del informe previo (estimado; sin verificar con hojas de datos)
Potencia digital nominal | 0.330 | W | P = V·I
Potencia digital pico | 0.825 | W | P = V·I
NOTA |  |  | El consumo de las bobinas no se calcula porque no se definió su resistencia; queda pendiente. La corriente real del DRV8833 depende de VM, de la bobina y de la limitación del driver.

Sheet: Restricciones
ID | Origen (requisito/ET/interfaz) | Restricción y alcance (condición, valor, unidad, redes/componentes) | Tipo | Fuente y fundamento | Aplicación (dónde se registra) | Verificación | Estado
PCB-01 | ET alimentación / MAIN_BUS_POWER | Pista de MAIN_BUS_POWER (J_EPS pin 1) y VM del DRV8833: ancho mínimo según Calculos B28 (≈0,30 mm para 1 A y ≈0,53 mm para 1,5 A, ΔT 10 °C, 1 oz externa); usar >= 1 mm como objetivo de diseño por margen y caída de tensión. Evitar cuellos de botella en vías: mínimo 2 vías 0,3/0,6 mm por transición. | Inferencia + recomendación | IPC-2221 (cálculo en hoja Calculos); corriente supuesta 1 A (informe previo 1-1,5 A). | Regla de ancho en PCB (Design Rule width) por clase de red POWER | Revisión DRC + cálculo; verificar caída de tensión con longitud real | Pendiente de layout
PCB-02 | Dominio ADCS aislado | Dominios DGND y PGND separados galvánicamente. Distancia mínima (creepage/clearance) entre copper de DGND y de PGND en la zona del ISO7741: >= 8 mm de pad a pad en el aislador DW (SOIC-16 ancho) y sin cobre ni planos bajo el aislador en la barrera. | Exigida por componente + recomendación | ISO7741DWR: aislamiento 5000 Vrms (DigiKey/TI). Distancia exacta: hoja de datos TI, sección Package/Insulation Specifications (por confirmar valor numérico). | Regla de clearance entre clases DGND/PGND; nota en esquemático | Medición en layout (DRC + inspección) | Pendiente de layout
PCB-03 | Dominio ADCS aislado | El plano/retorno de PGND no debe cruzar ni solaparse con DGND. Un único punto de conexión no existe (aislamiento total); los retornos de las bobinas vuelven a PGND por el lado del DRV8833. | Recomendación | Práctica estándar de aislamiento galvánico; cambio documentado en el informe, Sección 2.3. | Clases de red / polígonos separados | Inspección de planos | Pendiente de layout
PCB-04 | DRV8833 / J_COIL_X, J_COIL_Y | Pad térmico (PowerPAD) de U4 conectado a PGND con matriz de vías térmicas (mín. 5 vías 0,3 mm de taladro) a plano de PGND. Zona de cobre ampliada alrededor del pad. | Recomendación del fabricante | Hoja de datos DRV8833, sección Layout (PowerPAD) - confirmar número de vías recomendado. | Nota de ubicación en esquemático (textual) | Inspección + simulación térmica opcional | Pendiente de layout
PCB-05 | STM32H753 / alimentación | Un condensador de desacoplamiento de 100 nF por cada par VDD/VSS, a <= 3 mm del pin, con vía directa al plano. El esquemático actual NO incluye estos condensadores (ver Desviaciones D-08); deben añadirse o compensarse con condensadores en la zona de layout. | Exigida por hoja de datos | AN4938 / datasheet STM32H753 (sección Power supply scheme). Cantidad exacta por confirmar. | Nota en esquemático; regla de ubicación en layout | Revisión manual del layout | Desviación abierta
PCB-06 | STM32H753 / VCAP | Condensadores VCAP (C3, C4 de 2,2 uF) lo más cerca posible de los pines VCAP (81, 125), ESR < 100 mohm (cerámico X7R/X5R). | Exigida por hoja de datos | Datasheet STM32H753, sección Power supply scheme (VCAP). Confirmar valor y ESR. | Nota de ubicación | Inspección de layout | Pendiente de layout
PCB-07 | Reloj HSE | Cristal Y1 y condensadores C2, C5 juntos, a <= 5 mm de PH0/PH1; sin pistas de otras señales ni vías bajo el cristal; guarda de GND (DGND) alrededor. | Recomendación del fabricante | AN2867 (Oscillator design guide for STM8/STM32) - confirmar aplicabilidad al H7. | Nota de ubicación | Inspección | Pendiente de layout
PCB-08 | Reloj HSE | Capacitancia de carga CL = 18 pF (a verificar): requiere Cext ≈ 30 pF por lado con Cstray = 3 pF; instalado 16 pF. Desviación abierta. | Exigida por hoja de datos | Hoja de datos ABM3B-25.000MHZ-B4U-T (por confirmar) + Calculos B3-B9. | Esquemático (valores de C2, C5) | Cálculo en hoja Calculos | Desviación abierta
PCB-09 | IF-04 PAYLOAD_SPI | SPI hacia el payload: resistencias serie de 33 ohm (R2-R5) ubicadas cerca del origen (STM32). Longitud de pista < 100 mm si es posible; sin cruces de planos. | Recomendación | Práctica de integridad de señal; impedancia no controlada en esta etapa. | Nota + clase de red SPI | Inspección | Pendiente de layout
PCB-10 | IF-05 TELEMETRY_I2C | Pull-ups de 4,7 kohm (R6, R7) a 3V3_DIGITAL dentro del intervalo [967 ohm; 7,08 kohm]. | Cálculo | Hoja Calculos B16-B19 (especificación I2C). | Valores en esquemático | Cálculo | Cumple
PCB-11 | IF-01 CAMERA_DCMI | Bus DCMI (D0-D7, PCLK, HSYNC, VSYNC): grupo de longitud con diferencia máxima entre D0-D7 y PCLK a definir en la guía de enrutamiento (objetivo preliminar <= 5 mm); referencia continua de plano. | Inferencia (objetivo) | Requisito ET-01 >= 40 MB/s (informe). Valor numérico por derivar de la hoja de datos de la cámara (no disponible en este paquete). | Parameter Set / clase de red DCMI (por crear) | Medición de longitudes en layout | Pendiente (valor por definir)
PCB-12 | FMC_BUS (SDRAM) | Bus FMC SDRAM: línea de reloj FMC_SDCLK emparejada en longitud con el grupo de datos/control (objetivo <= 10 mm de diferencia); cobertura por plano de referencia; la SDRAM junto al STM32. | Inferencia (objetivo) | Práctica común para SDRAM síncrona (timing del MT48LC4M16A2P-6A, hoja de datos: sección AC Timing). Valores numéricos por confirmar. | Parameter Set / clase FMC (por crear) | Medición de longitudes | Pendiente (valor por definir)
PCB-13 | SDIO_BUS (eMMC) | Bus SDIO: CLK separado de D0-D7 y CMD; diferencia de longitud entre líneas <= 5 mm (objetivo); eMMC en BGA FBGA-153: abanico con vías de 0,15-0,2 mm (HDI o POFV según proveedor). | Inferencia + límite de fabricación | Datasheet Kingston EMMC04G-M627-A01 (por confirmar) y guía BGA de JLCPCB (https://jlcpcb.com/help/article/243-BGA-Design-Guidelines---PCB-Layout-Recommendations-for-BGA-packages). | Clase de red SDIO | Inspección DRC | Pendiente de layout
PCB-14 | SWD (J1) | SWDIO y SWCLK cortos (< 50 mm) hacia el conector J1; NRST disponible en test point. | Recomendación | Práctica; el informe prevé puntos de prueba NRST, VCAP, 3.3V_Iso y PWM. | Test points (por añadir; ver Desviaciones D-10) | Inspección | Desviación abierta
PCB-15 | Térmico | Disipación del DRV8833 y de las pistas de bobinas: cobre de superficie ampliado y, si se justifica, capa interna de potencia; ΔT admisible 10 °C como objetivo. | Recomendación | Hoja de datos DRV8833; IPC-2221. | Nota | Simulación opcional | Pendiente
PCB-16 | Conectores | J1 (53259-0429) y cabeceras de cables en el borde de la tarjeta; huella de THT con agujeros de taladro según datasheet Molex; pitch 3,5 mm (J1). | Exigida por huella | Datasheet Molex 53259-0429 (patrón recomendado). | Huella en UD34_Footprints.PcbLib | Comparación de huella vs hoja de datos | Pendiente de verificación
FAB-01 | Proveedor | Proveedor elegido: JLCPCB (fabricación de PCB rígida estándar). Capacidades consultadas el 27/10/2026 en https://jlcpcb.com/capabilities/pcb-capabilities y https://api.jlcpcb.com/capabilities/Capabilities. Los valores pueden cambiar; reconsultar antes del pedido. | Fuente externa | JLCPCB, páginas de capacidades (fecha de consulta 27/10/2026). | Documentado aquí | Reconsulta al pedir | Documentado
FAB-02 | Apilamiento | Número de capas preliminar: 4 capas (señal / GND / alimentación / señal), FR-4, 1,6 mm, cobre exterior 1 oz (0,035 mm). Justificación: BGA FBGA-153, 176 pines LQFP, bus FMC de 38 señales y dominios aislados. Cálculo de impedancias y apilamiento definitivos quedan para la guía de enrutamiento. | Inferencia | JLCPCB: soporta 1-32 capas, impedancia controlada de 4 capas en adelante, con apilamientos por defecto. | Nota; regla de capas en layout | Revisar apilamiento en guía de enrutamiento | Pendiente (valor preliminar)
FAB-03 | Pistas y separación | Ancho y separación mínimos en capa exterior a usar en diseño: >= 0,127 mm (5 mil) / 0,127 mm (5 mil) para 1-2 capas; objetivo de diseño >= 0,15 mm / 0,15 mm para tener margen. En multicapa JLCPCB indica 3,5 mil como límite; no se usa por margen. | Límite de fabricante | JLCPCB capabilities (resumen verificado vía secundaria: Trace width/spacing 5 mil 1-2L; 3,5 mil multicapa). Reconsultar el valor exacto de 4 capas en la página oficial. | Regla de diseño (Width/Clearance) en layout | DRC | Pendiente de layout
FAB-04 | Vías y taladros | Vía estándar: taladro 0,3 mm / diámetro 0,5 mm (2 capas) o taladro 0,2 mm / diámetro 0,45 mm (multicapa); vías de abanico de BGA con taladro 0,15 mm / diámetro 0,25 mm (según la guía BGA y 'Via-in-pad' con relleno, POFV gratuito en 6-20 capas). Taladro mínimo 0,2 mm; máximo 6,3 mm. | Límite de fabricante | JLCPCB capabilities (https://api.jlcpcb.com/capabilities/Capabilities) y guía BGA (https://jlcpcb.com/help/article/243-BGA-Design-Guidelines---PCB-Layout-Recommendations-for-BGA-packages). | Reglas de vía en layout | DRC | Pendiente de layout
FAB-05 | Anillo anular / máscara | Anillo anular mínimo de pad >= 0,15 mm sobre el taladro (valor registrado por fuente secundaria). Puente de máscara de soldadura mínimo según proveedor; verificar para el paso de 0,5 mm del LQFP-176 y del FBGA-153. | Límite de fabricante | JLCPCB (valores a confirmar en la página oficial); la separación mínima entre pines de IC es 0,4 mm (0,35 mm extremo). | Reglas de máscara en layout | DRC | Pendiente (confirmar)
FAB-06 | Borde de tarjeta | Distancia de pista a borde >= 0,2 mm (fresado) como límite del fabricante; objetivo de diseño >= 0,3 mm. Tamaño de lote en prototipo: tarjeta individual 70x70 mm mínimo / 400x500 mm máximo en el servicio estándar. | Límite de fabricante | JLCPCB capabilities (Trace to Outline 0,2 mm; Single PCB Size). | Regla de borde + contorno | DRC | Pendiente
FAB-07 | Tamaño de la placa | Tamaño de la PCB debe respetar el formato 1U del CubeSat (~ 90 x 96 mm de la placa PC/104). Si es menor de 70 x 70 mm, verificar los mínimos del servicio estándar de JLCPCB. | Inferencia | Estándar CubeSat 1U / PC/104 (por confirmar en la arquitectura de la práctica 3). | Contorno de placa | Revisión mecánica | Pendiente
FAB-08 | Servicios especiales | Posible necesidad de servicio especial: vía rellena (POFV/via-in-pad) y/o HDI para el FBGA-153 a paso 0,5 mm; impedancia controlada si se exige. Identificado para consultar a JLCPCB. | Inferencia | Guía BGA de JLCPCB. | Nota | Consulta con el proveedor | Pendiente
Tipos de fuente: 'Exigida' = condición impuesta por una hoja de datos o fabricante; 'Recomendación' = práctica adoptada por el equipo; 'Inferencia' = deducción propia del equipo. Los valores marcados 'por confirmar' no se pudieron contrastar con la hoja de datos en esta entrega.

Sheet: ERC
Fecha/hora | Hoja | Mensaje(s) | Causa | Acción / resolución | Estado
27/10/2026 06:03 | Top_Level.SchDoc | [Fatal Error] Missing Harness Type on Signal Harness | Había un tramo de cable de harness suelto fuera del diagrama y Sheet Entries sin Harness Type (TELEMETRY_I2C, PAYLOAD_SPI). | Se asignó el Harness Type correcto a los Sheet Entries y se eliminó el cable suelto. | Resuelto
27/10/2026 06:03 | U_Interfaces_Connectors / U_OBC_Core | Duplicate Component Designators C5, J1; Duplicate Net Names NetC5_1 | Designadores repetidos entre hojas y eMMC sin anotar ('*'). | Tools > Annotation > Reset All y Annotate Schematics (Across Then Down). | Resuelto
27/10/2026 06:20 | Top_Level.SchDoc | Duplicate Net Names Wire FMC_SDNE0 | Dos objetos con el mismo nombre en Top_Level. | Corregido en el esquemático. | Resuelto (verificado a las 06:22: ya no aparece)
27/10/2026 06:22 | U_Mass_Storage.SchDoc | Net CLK/CMD has only one pin; Net FMC_* contains floating input pins / has only one pin (decenas de mensajes) | Las señales FMC, SDIO (y DCMI) llegan hasta U_OBC_Core pero los net labels no están conectados a pines del STM32H753. | NO corregido en esta versión. Se acepta como EXCEPCIÓN DOCUMENTADA: la asignación de pines FMC/SDIO/DCMI se hará en CubeMX y se conectará en la siguiente revisión (Desviación D-01). No se desactivó el ERC globalmente. | Excepción aceptada (abierta)
 | Revisión manual | Pendiente: revisión cruzada entre ambos integrantes | Debe hacerse y documentarse antes de entregar. | Completar fecha, revisor y observaciones. | PENDIENTE

Sheet: Desviaciones
ID | Tema | Especificación / informe previo | Esquemático as-built | Impacto | Acción propuesta (siguiente revisión) | Estado
D-01 | FMC / SDIO / DCMI | STM32 conectado a SDRAM, eMMC y cámara | Net labels sin conexión a pines del STM32H753 | SDRAM, eMMC y cámara sin enlace con el MCU: no funcionan | Asignar pines en STM32CubeMX (SDMMC 4 u 8 bits, FMC SDRAM, DCMI 8 bits) y conectar | Abierta
D-02 | Aislador ISO7741 | Aislar las 4 señales PWM (A1, A2, B1, B2) | ISO7741 tiene 3 canales en una dirección: PWM_B2 no llega al DRV8833 y BIN2 (pin 10) queda sin conexión | Un puente del DRV8833 queda con una entrada flotante; control de la bobina Y incompleto | Cambiar a ISO7740 (4 canales en el mismo sentido) o reasignar canales | Abierta
D-03 | Alimentación del puente H | VBATT 7,4-8,4 V directo al DRV8833; DCP010505BP solo para el lado aislado lógico | VM del DRV8833 y VCC2 del ISO7741 conectados a la etiqueta 5V_ISO; no hay fuente que genere 5V_ISO (DCP010505BP no está en el esquemático); J_EPS (3 pines) no lleva VBATT | El lado aislado no tiene alimentación definida | Añadir DCP010505BP (o fuente equivalente), llevar VBATT al conector y a VM | Abierta
D-04 | IMU | TDK ICM-20948 en la tabla de componentes | No existe en ninguna hoja | Sin sensado de actitud en esta tarjeta | Añadir IMU (I2C/SPI) y asignar pines | Abierta
D-05 | Ejes de actuación | Tres ejes de magnetorquers | Solo COIL_X y COIL_Y (un DRV8833 = 2 puentes H) | Falta eje Z | Añadir segundo DRV8833 y canales de aislamiento, o declarar 2 ejes como simplificación del alcance | Abierta (se declara 2 ejes)
D-06 | Cristal HSE | Informe: CL = 8 pF, C = 12 pF | C2 = C5 = 16 pF; cristal ABM3B-25.000MHZ-B4U-T cuya CL reportada es 18 pF | Posible error de frecuencia/arranque del oscilador | Verificar CL en hoja de datos y recalcular (Cext ≈ 30 pF con Cstray = 3 pF) | Abierta
D-07 | SDRAM | Informe previo: ISSI IS42S16400J-7TL | Micron MT48LC4M16A2P-6A | Informe desactualizado; Last Time Buy vencido (30/06/2026) | Informe corregido para reflejar el esquemático; evaluar alternativa (ISSI o Alliance Memory) | Corregido en informe
D-08 | Desacoplamiento STM32 | Condensador cerámico cerca de cada pin de alimentación | Un solo 100 nF (en NRST); 14 VDD sin condensador dedicado | Riesgo de integridad de alimentación | Añadir 100 nF por par VDD/VSS y 4,7 uF de volumen | Abierta
D-09 | eMMC VCCQ | Informe previo: VCCQ = 1,8 V | VCCQ = 3V3_DIGITAL | El informe se corrigió al esquemático | Mantener 3,3 V si la interfaz del host lo permite | Corregido en informe
D-10 | Puntos de prueba | NRST, VCAP, 3.3V_Iso, PWM | No hay test points en el esquemático | Dificulta la verificación de la tarjeta | Añadir test points | Abierta
D-11 | Pines PWM vs FMC | - | PWM_A1/A2/B1/B2 asignados a PE9, PE11, PE13, PE14, que son pines de datos de FMC | Conflicto al conectar FMC | Reasignar PWM a pines de timer libres en CubeMX | Abierta
D-12 | Conectores | PC/104 de apilamiento y mezzanine de alta densidad | Cabeceras genéricas (3, 4, 5 y 16 pines); J_EPS sin 5 V ni VBATT | Interfaces sin definición final de pines | Definir conectores comerciales y tabla de pines | Abierta
D-13 | Cajetín de hojas | Título, número, revisión y autores | Cajetines vacíos | Falta identificación de las hojas | Rellenar Title, Number, Revision, Drawn By | Abierta
