JuanGonzalez47/CubeSat_UD34_Electronic_Products_Design/Lab04/PDF_Esquematicos/Esquematicos_completos.pdf

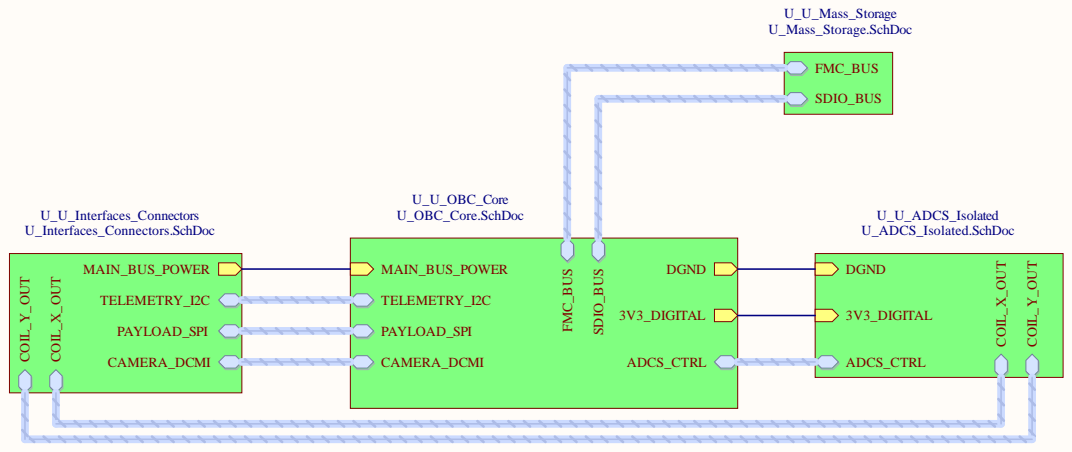
[picture p9: page 1]

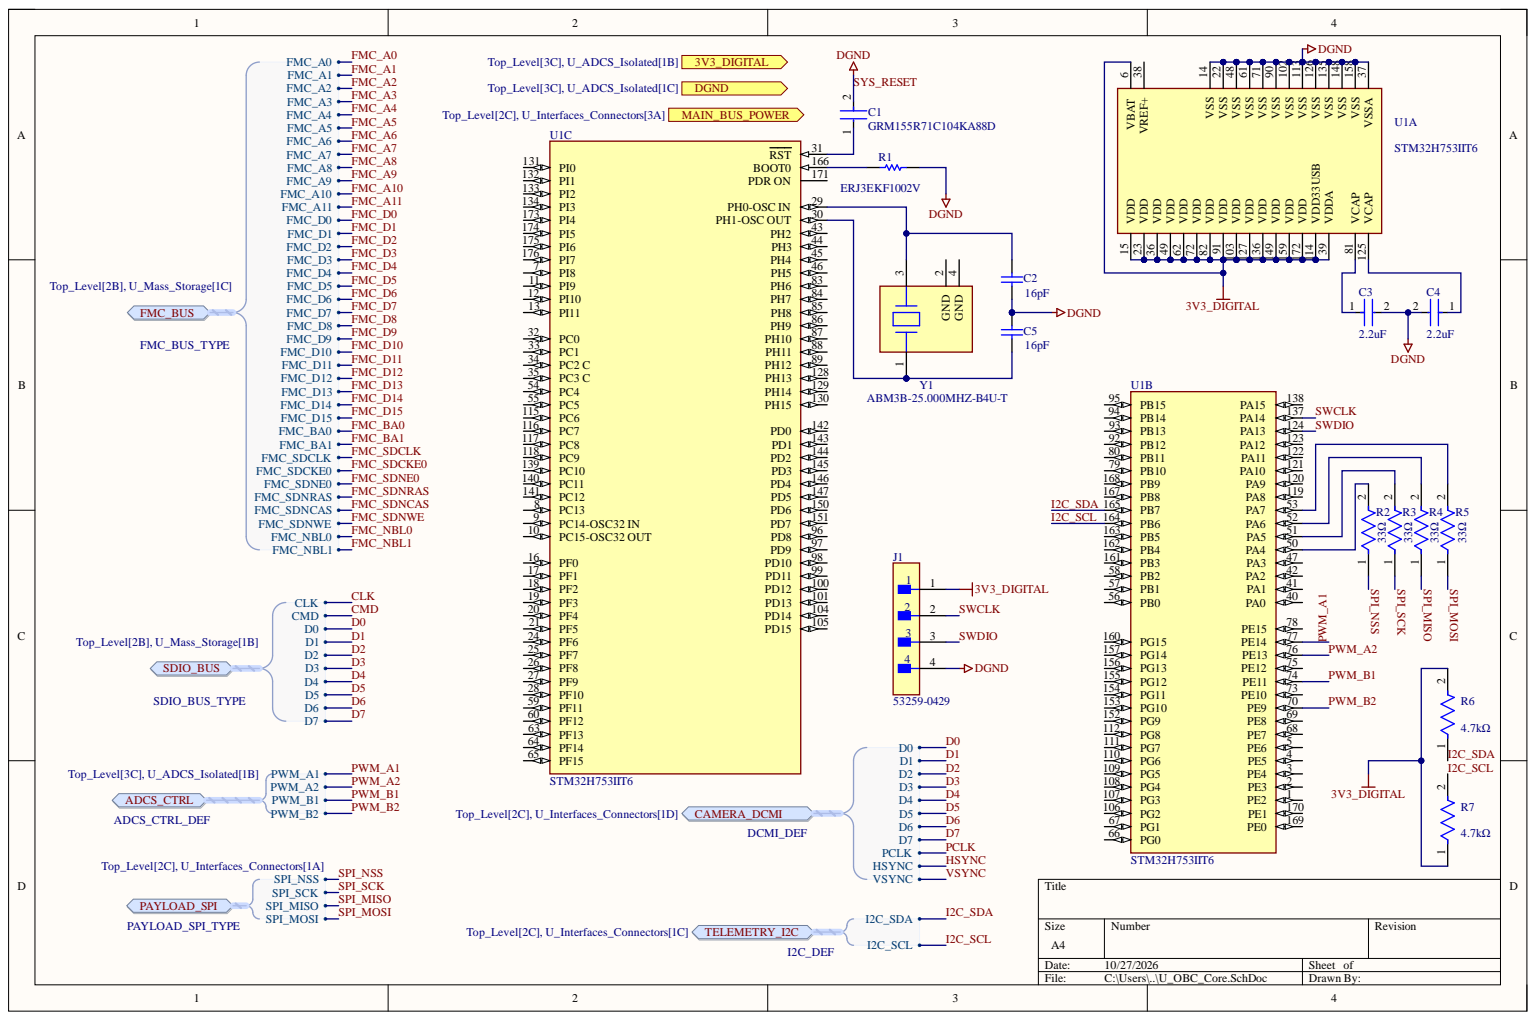
[picture p10: page 2]

3 0
4 3

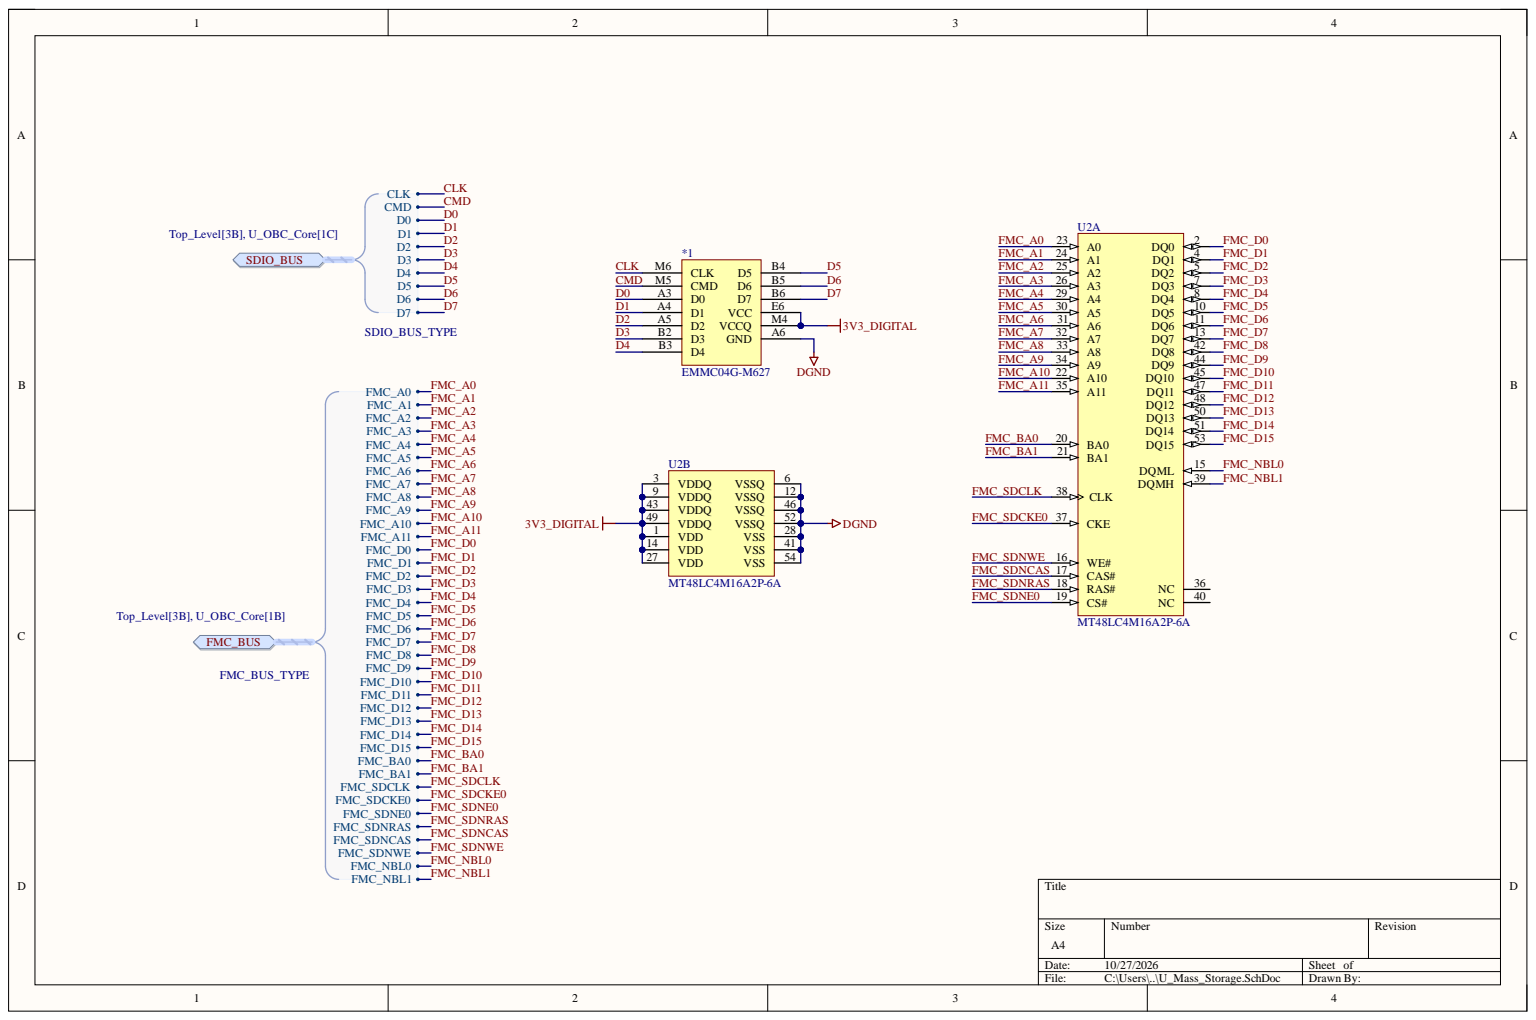
[picture p11: page 3]

9 | | 1 2
4 3 | | 4 6
4 9 | | 5 2 2 8

1 4 | | 4 1
2 7 | | 5 4

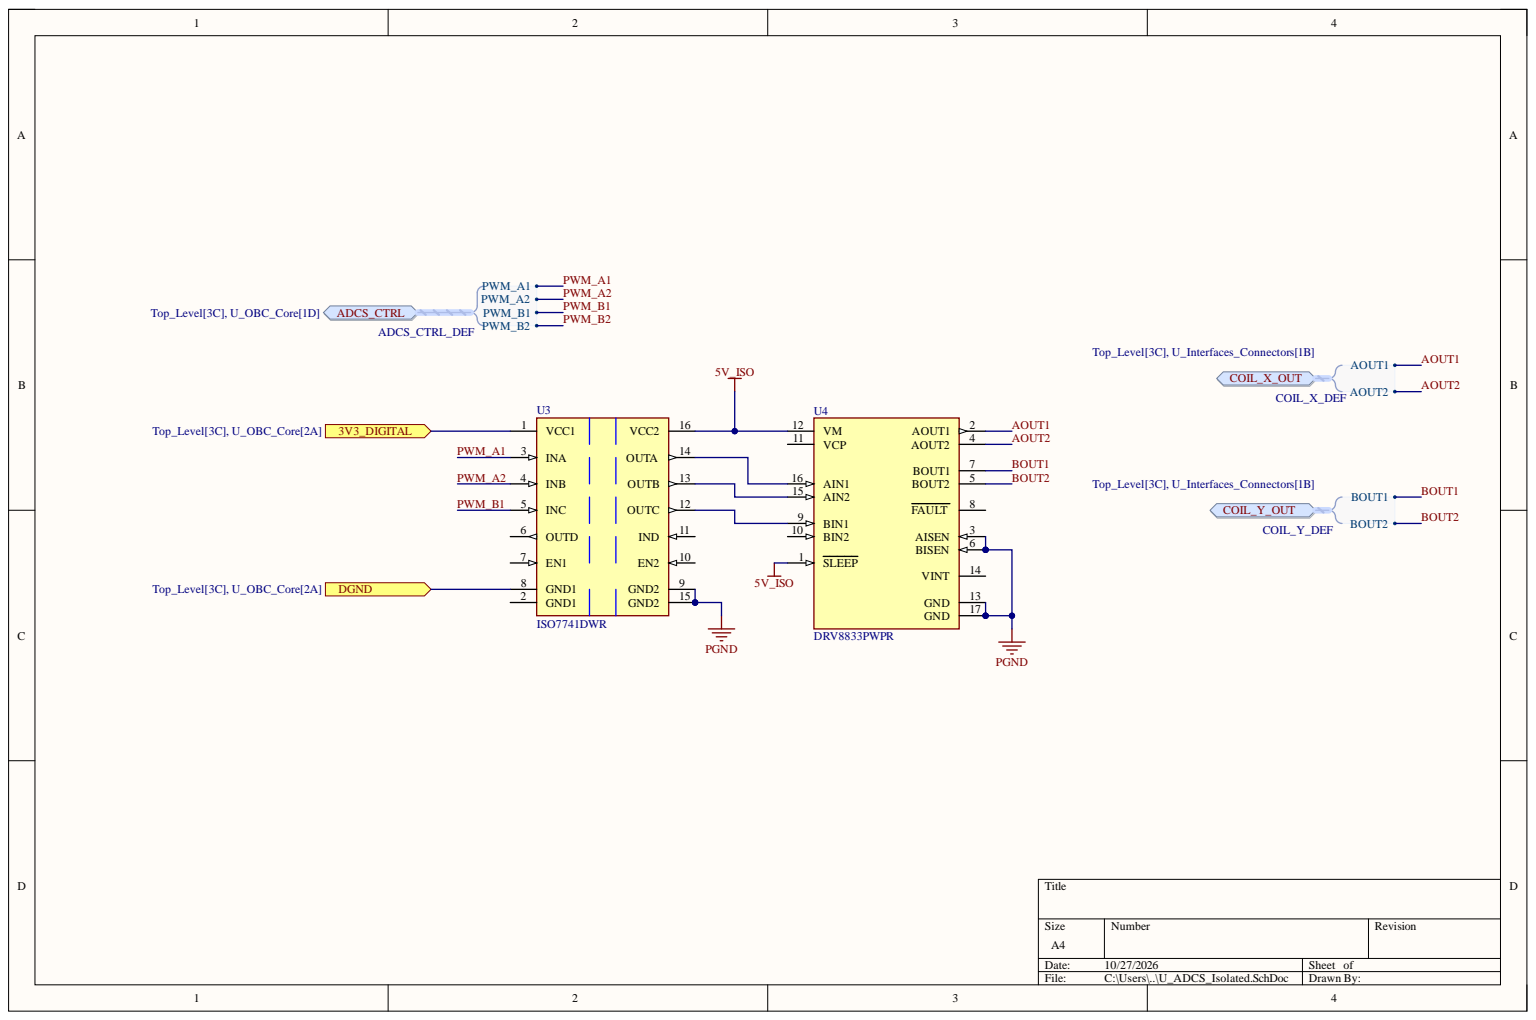
[picture p12: page 4]

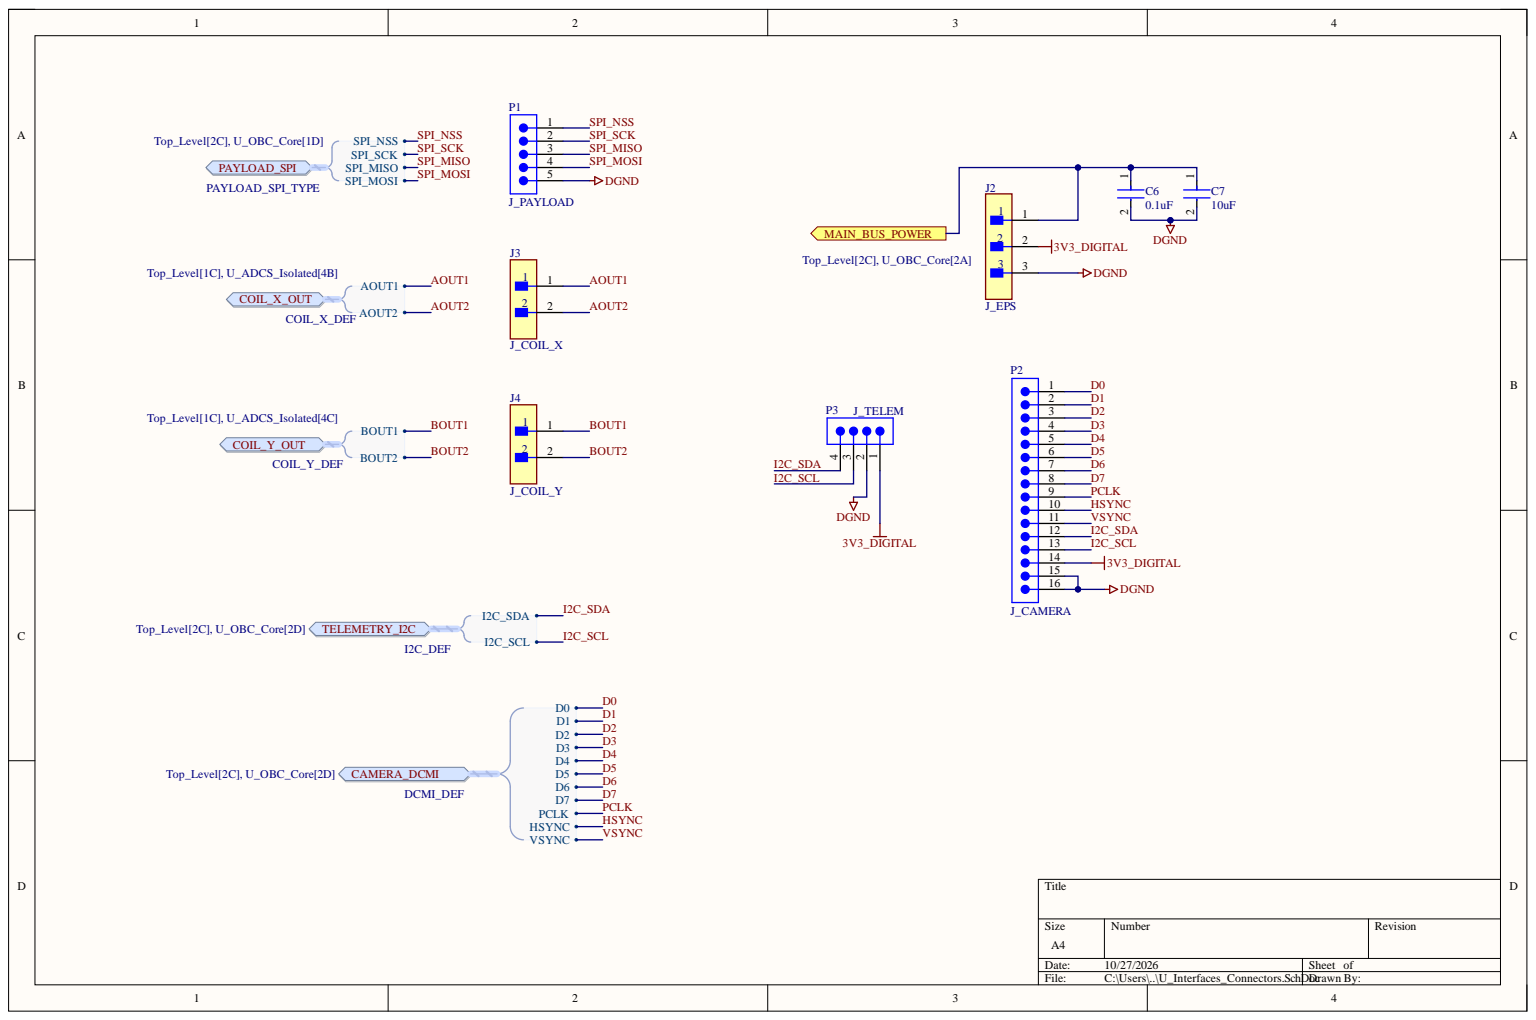
[picture p13: page 5]
