JuanGonzalez47/CubeSat_UD34_Electronic_Products_Design/(list of files, drawings)

Other design files:
Lab04/Esquematicos/2_Libraries/UD34_Footprints.PcbLib
Lab04/Esquematicos/2_Libraries/UD34_Sym.SchLib
Lab04/Esquematicos/3_Datasheets/DRV8833PWPR/Components - 26.10.26 - 14.31.PcbLib
Lab04/Esquematicos/3_Datasheets/DRV8833PWPR/Components - 26.10.26 - 14.31.SchLib
Lab04/Esquematicos/3_Datasheets/DRV8833PWPR/Components - 26.10.26 - 14.31/Components - 26.10.26 - 14.31.SchLib
Lab04/Esquematicos/3_Datasheets/ISO7741DWR/Components - 26.10.26 - 18.57.PcbLib
Lab04/Esquematicos/3_Datasheets/ISO7741DWR/Components - 26.10.26 - 18.57.SchLib
Lab04/Esquematicos/3_Datasheets/MT48LC4M16A2P/Components - 27.10.26 - 00.39.PcbLib
Lab04/Esquematicos/3_Datasheets/MT48LC4M16A2P/Components - 27.10.26 - 00.39.SchLib
Lab04/Esquematicos/3_Datasheets/STM32H753IIT6/Components - 26.10.26 - 22.22.PcbLib
Lab04/Esquematicos/3_Datasheets/STM32H753IIT6/Components - 26.10.26 - 22.22.SchLib
Lab04/Esquematicos/PCB2_OBC_ADCS/PCB2_OBC_ADCS.PrjPcb
Lab04/Esquematicos/PCB2_OBC_ADCS/Top_Level.SchDoc
Lab04/Esquematicos/PCB2_OBC_ADCS/U_ADCS_Isolated.SchDoc
Lab04/Esquematicos/PCB2_OBC_ADCS/U_Interfaces_Connectors.SchDoc
Lab04/Esquematicos/PCB2_OBC_ADCS/U_Mass_Storage.SchDoc
Lab04/Esquematicos/PCB2_OBC_ADCS/U_OBC_Core.SchDoc
