JuanGonzalez47/CubeSat_UD34_Electronic_Products_Design/(commit log)

2026-09-27 Entregables Lab03
    [Calificación Arquitecturas.xlsx, Conexiones Esenciales.xlsx, Especificaciones.xlsx, Funciones HW-FW.xlsx, Presupuesto - Subsistemas.xlsx, Presupuesto Telematria - Sensores.xlsx, Requisitos.xlsx]
2026-10-27 Correción de errores en los esquemáticos
